PhobGCC/PhobGCC-HW/README.md

# PhobGCC-HW
Seperate repository for the hardware used in the PhobGCC
