PhobGCC/PhobGCC-HW/PCB/Graphics/Cute Ghost Big Smile.png

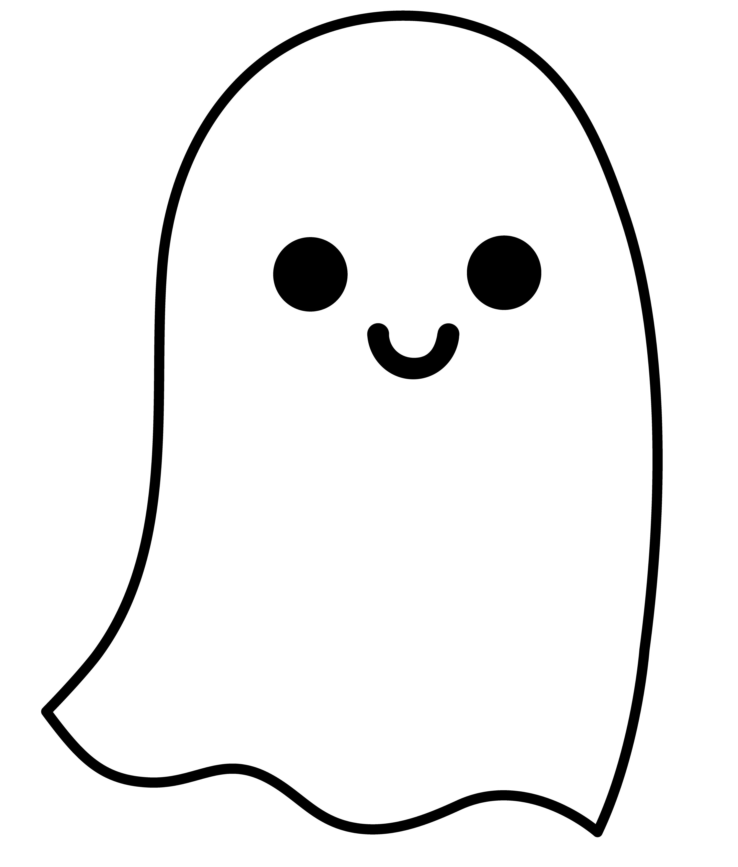
PCB/Graphics/Cute Ghost Big Smile.png
