PhobGCC/PhobGCC-HW/PCB/Graphics/Cute Ghost Filled.png

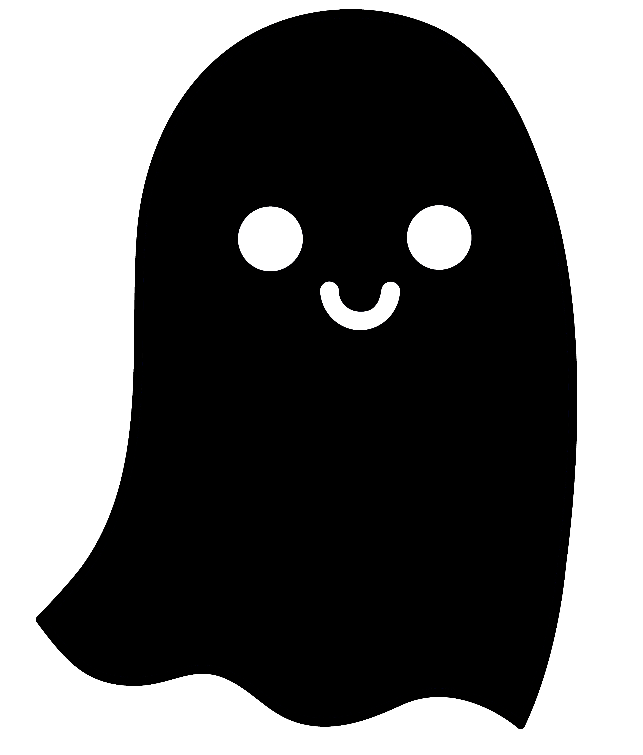
PCB/Graphics/Cute Ghost Filled.png
