PhobGCC/PhobGCC-HW/PCB/Graphics/Board Outline.DXF

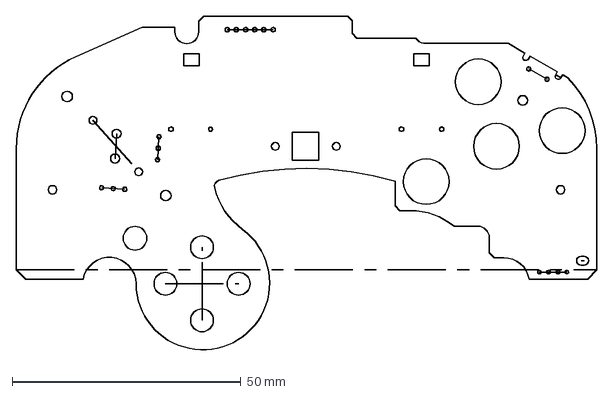
[picture p3: CAD file, 2022-04-02]
PCB/Graphics/Board Outline.DXF
127.0 x 74.1 mm
