PhobGCC/PhobGCC-HW/PCB/Models/D2LS_21.step

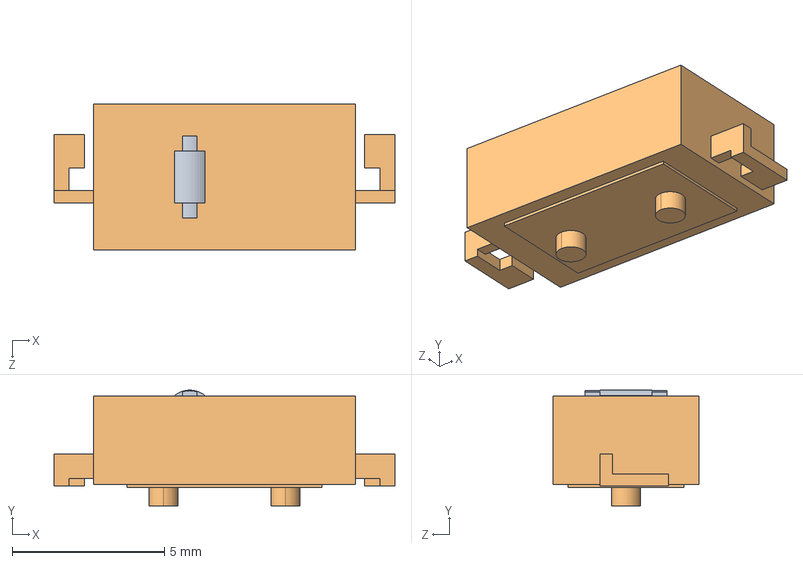
[picture p4: CAD file, 2022-04-02]
PCB/Models/D2LS_21.step
11.2 x 3.80 x 4.80 mm
D2LS_21_BUTTON
D2LS_21_BASE
