PhobGCC/PhobGCC-HW/PCB/Models/t2 Stickbox.STEP

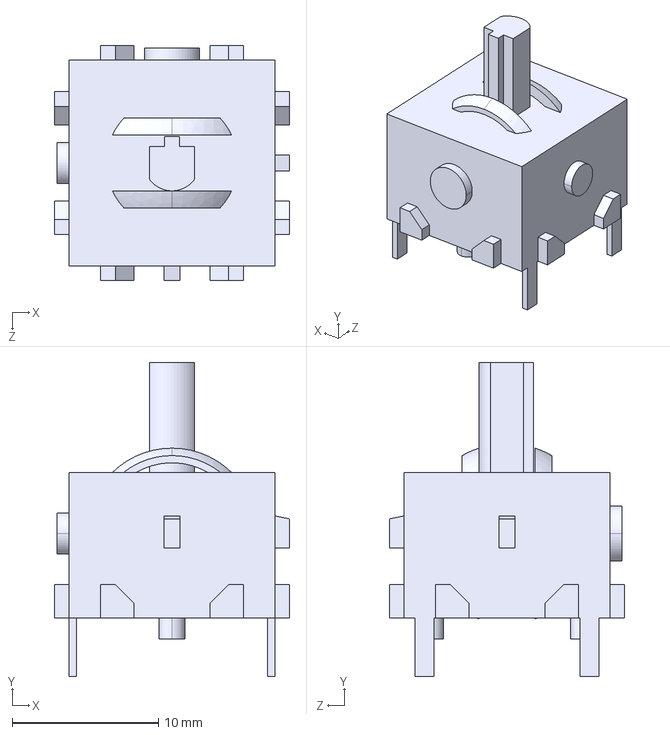
[picture p5: CAD file, 2022-04-02]
PCB/Models/t2 Stickbox.STEP
16.1 x 21.4 x 16.1 mm
