PhobGCC/PhobGCC-HW/PCB/Models/Sharp_Microelectronics_-_GP2S60.step

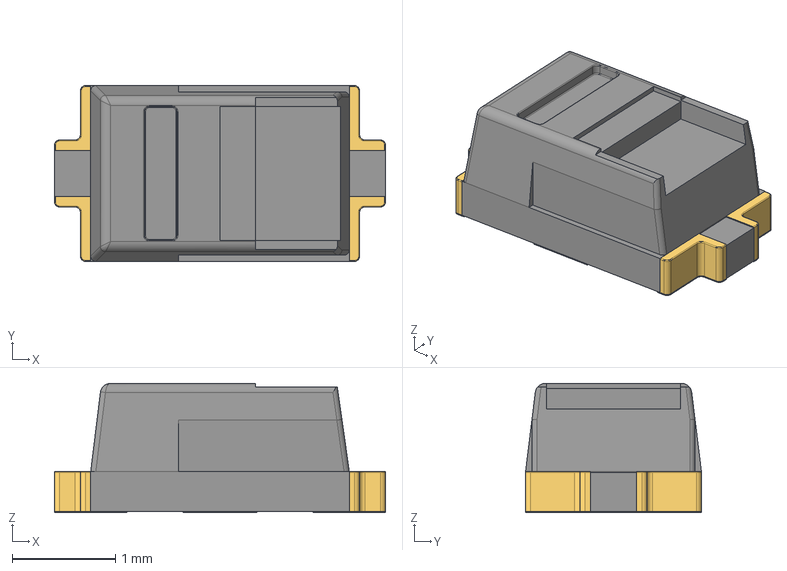
[picture p6: CAD file, 2022-04-02]
PCB/Models/Sharp_Microelectronics_-_GP2S60.step
3.20 x 1.70 x 1.25 mm
