PhobGCC/PhobGCC-HW/PCB/Models/10118194c.step

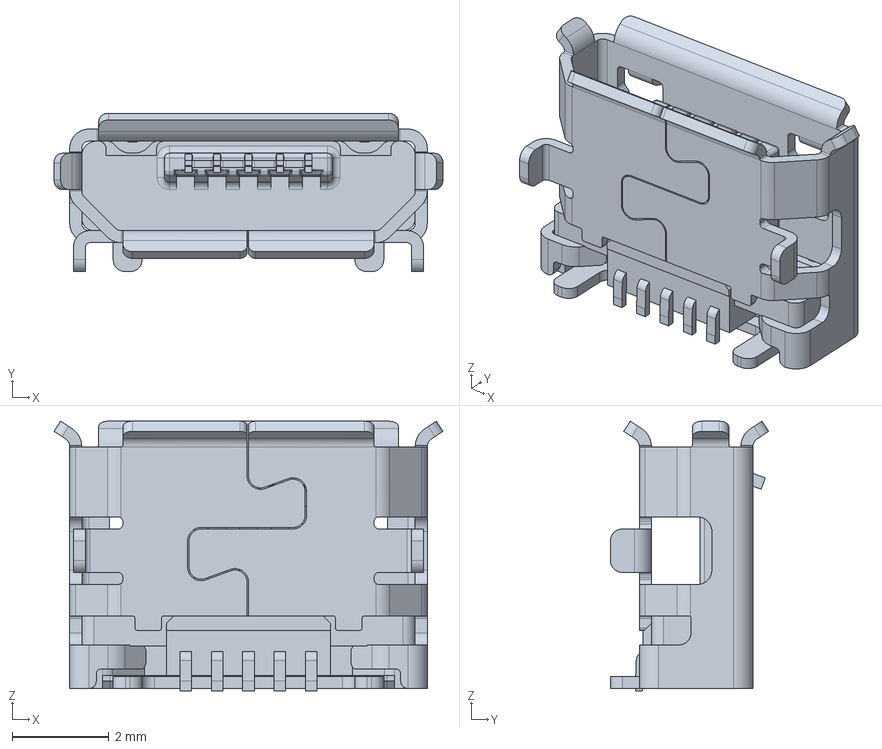
[picture p7: CAD file, 2022-04-02]
PCB/Models/10118194c.step
8.05 x 3.27 x 5.58 mm
