PhobGCC/PhobGCC-HW/(commit log)

2022-04-02 First commit bringing in the board version 1.2 design files
    [10118194c.step, Board Outline.DXF, CStick.kicad_pcb, CStick.kicad_sch, D2LS_21.step, PhobGCC.kicad_pcb, PhobGCC.kicad_sch, Reflector.kicad_pcb]
2022-04-06 Added link to github, updated dpad pads, added another bypass cap for x hall sensor and positioned them closer, removed TX-RX data a renamed net to Data
    [PhobGCC.kicad_pcb, PhobGCC.kicad_sch]
2022-05-11 Renamed the libraries, increased capacitance on 5V line, added DNP diode in case reverting to previous comms setup is needed
    [PhobGCC.kicad_pcb, PhobGCC.kicad_sch, Reflector.kicad_pcb]
2022-05-12 Little bit of clean up for the release
    [PhobGCC.kicad_pcb]
2022-05-12 Changed board version to 1.2.1 to avoid confusion with boards I already made
    [PhobGCC.kicad_pcb]
2022-05-25 Combined C Stick and Main PCB
    [PhobGCC.kicad_pcb, PhobGCC.kicad_sch]
2022-05-25 update silkscreen
    [PhobGCC.kicad_pcb]
2022-05-26 Made all designators for sitches visible and moved a couple. Made the ghosts smile a bit thicker.
    [CStick.kicad_pcb, CStick.kicad_sch, PhobGCC.kicad_pcb, PhobGCC.kicad_sch]
2022-05-27 added LR version
    [PhobGCC.kicad_pcb, PhobGCC.kicad_sch]
2022-05-27 LR footprints
2022-05-28 fixed LR
    working on mouseclick LR boards.
    [PhobGCC.kicad_pcb, PhobGCC.kicad_sch]
2022-05-29 fixed LR board mouse switch footprint
    [PhobGCC.kicad_pcb, PhobGCC.kicad_sch]
2022-05-29 removed gerber
2022-05-30 Rerouted the data signal to pin 7 of the teensy first, then to pin 8. This will allow the trace between pins 7 and 8 to be cut and a diode installed if the half-duplex communication needs to be rever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
    [PhobGCC.kicad_pcb, PhobGCC.kicad_sch]
2022-05-30 flipped trigger boards
    [PhobGCC.kicad_pcb, PhobGCC.kicad_sch]
2022-06-01 fix dpad footprints
    [PhobGCC.kicad_pcb, PhobGCC.kicad_sch]
2022-06-01 schematic too
    [PhobGCC.kicad_sch]
2022-06-01 Silk & Footprint Rework
    Made minor edits to the footprints that were causing keepout area errors and silkscreen clearance errors to make it easier for newer designers to make sense of DRC (only error is GND plane of C-stick to GND plane of main PCB). removed labels from mounting holes and other non essential items (stickboxes, trigger sliders, teensy, some header pins) and labeled all buttons and important header pins. also moved some of the component labels so they lined up a bit better with their respective components.
    [PhobGCC.kicad_pcb, PhobGCC.kicad_sch]
2022-06-01 silk and footprint rework (combined)
    [PhobGCC.kicad_pcb, PhobGCC.kicad_sch]
2022-06-01 swapped fuse, fixed LR
    [PhobGCC.kicad_pcb, PhobGCC.kicad_sch]
2022-06-01 wide mousebites
    [PhobGCC.kicad_pcb, PhobGCC.kicad_sch]
2022-06-01 fixed footprints
    [PhobGCC.kicad_pcb]
2022-06-01 applied footprint changes to all pcbs
    forgot to change cstick and motherboard to reflect the new hall sensor footprint, fixed now.
    [CStick.kicad_pcb, CStick.kicad_sch, PhobGCC.kicad_pcb, PhobGCC.kicad_sch]
2022-06-02 fixed data line connection.
    [PhobGCC.kicad_pcb]
2022-06-02 1.2.2 overhaul
    [CStick.kicad_pcb, CStick.kicad_sch, PhobGCC.kicad_pcb, PhobGCC.kicad_sch, TriggerBoard.kicad_pcb, TriggerBoard.kicad_sch]
2022-06-04 Updates
    - switched rumble pads to SMD and matched OEM placement.
    - aligned both sets of trigger pads to be horizontal for convenience and consistency.
    - centered c-stick pins to the board edge.
    - rerouted some areas to have a more consistent copper fill.
    - fixed trigger board width (switched 7.5mm to 7.35mm).
    - increased dpad button pad size to make for easier hand soldering.
    [CStick.kicad_pcb, PhobGCC.kicad_pcb, PhobGCC.kicad_sch, TriggerBoard.kicad_pcb]
2022-06-04 Consolidated footprints to PhobGCC library
    [CStick.kicad_pcb, CStick.kicad_sch, PhobGCC.kicad_pcb, PhobGCC.kicad_sch, TriggerBoard.kicad_pcb]
2022-06-06 panel in progress
    [PhobGCC.kicad_pcb, PhobGCC.kicad_sch]
2022-06-22 1.2.3 changes
    omron tactile z support, larger c stick pin holes, relocated C10 from underneath button pad
    [CStick.kicad_pcb, CStick.kicad_sch, PhobGCC.kicad_pcb, PhobGCC.kicad_sch]
2022-06-22 LR spacing fix
    widened gap between trigger boards
    [PhobGCC.kicad_pcb, TriggerBoard.kicad_pcb]
2022-06-22 added back mini ghost
    [CStick.kicad_pcb, PhobGCC.kicad_pcb]
2022-06-22 removed panel
    panel in testing, not ready for main branch
    [PhobGCC.kicad_sch]
